ZhouA25/MakeCu2026/docs/design/pillbot-studio-gui.jpg

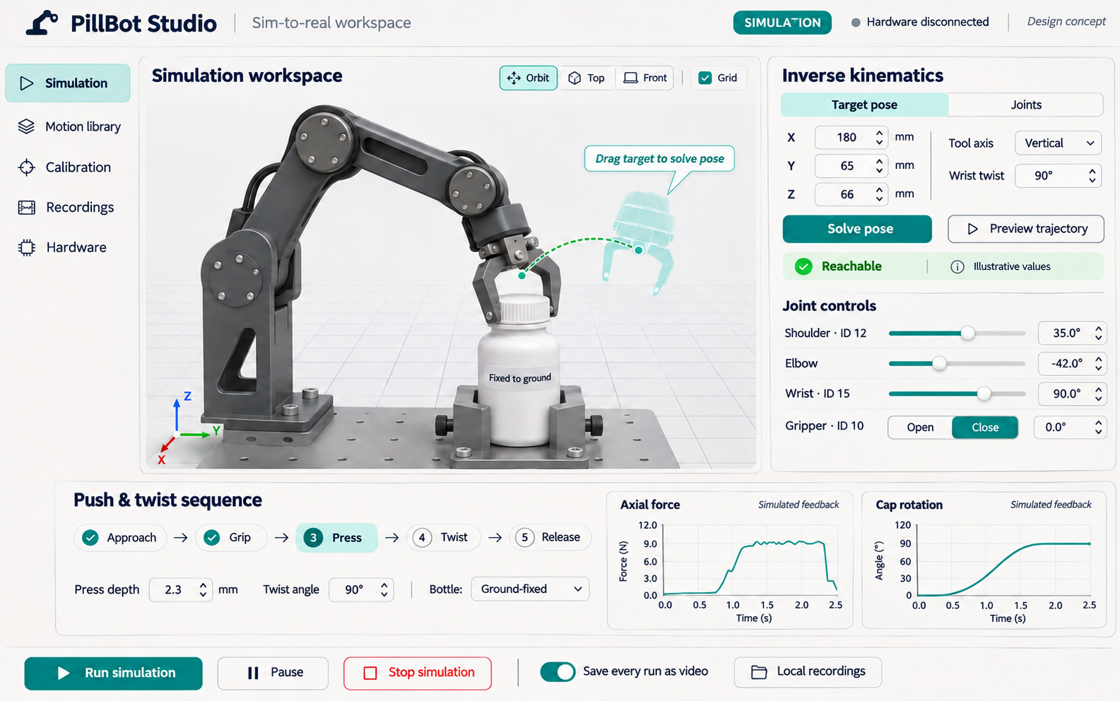
docs/design/pillbot-studio-gui.jpg
