ZhouA25/MakeCu2026/outputs/closed_loop/20261108T103255Z_grip_seed0_7902f1/00409_pass.png

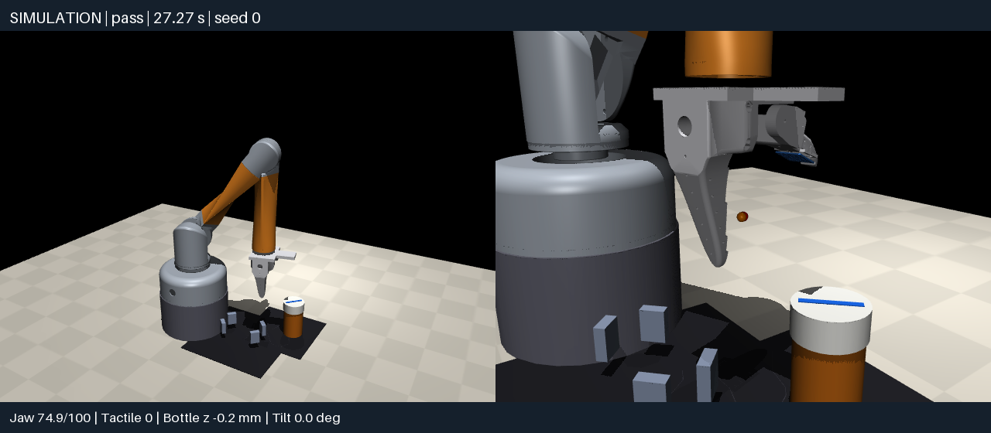
outputs/closed_loop/20261108T103255Z_grip_seed0_7902f1/00409_pass.png
