ZhouA25/MakeCu2026/docs/task-split.md

# Task split (fill in names)
| Area | Owner | Notes |
|---|---|---|
| Hardware: attachment CAD + printing | | hardware/cad, hardware/stl |
| Hardware: fixture + mounting | | |
| Robot setup: calibration, teleop, poses | | scripts/, control/teach.py |
| Control: open sequence tuning | | control/open_sequence.py |
| Perception | | perception/ |
| ML: record demos + train ACT | | scripts/record.sh, train.sh |
| Pitch + video | | docs/demo-plan.md |
