ZhouA25/MakeCu2026/outputs/closed_loop/20261108T103011Z_jaw_seed0_3709e4/00000_initial.png

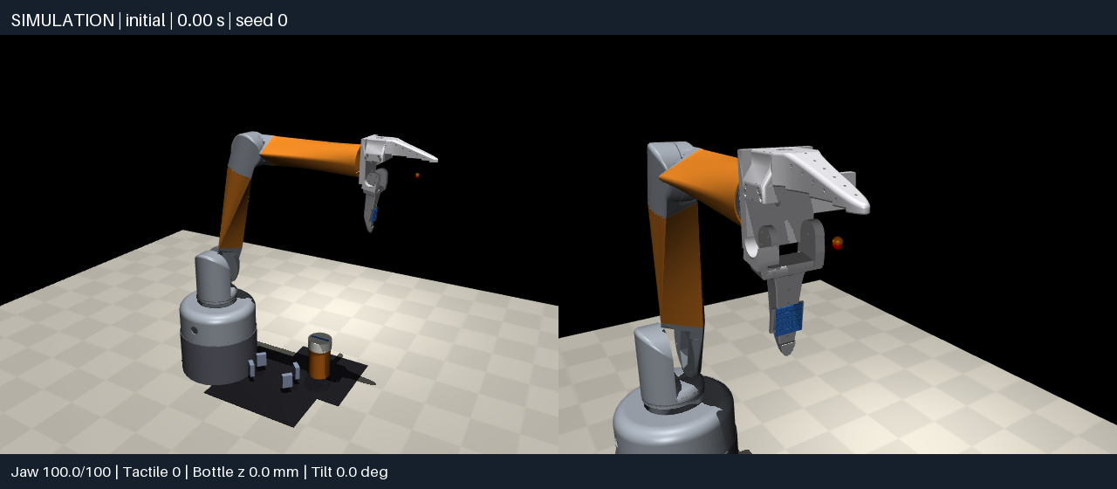
outputs/closed_loop/20261108T103011Z_jaw_seed0_3709e4/00000_initial.png
