ZhouA25/MakeCu2026/outputs/closed_loop/20261108T103031Z_grip_seed0_62903d/00387_fail.png

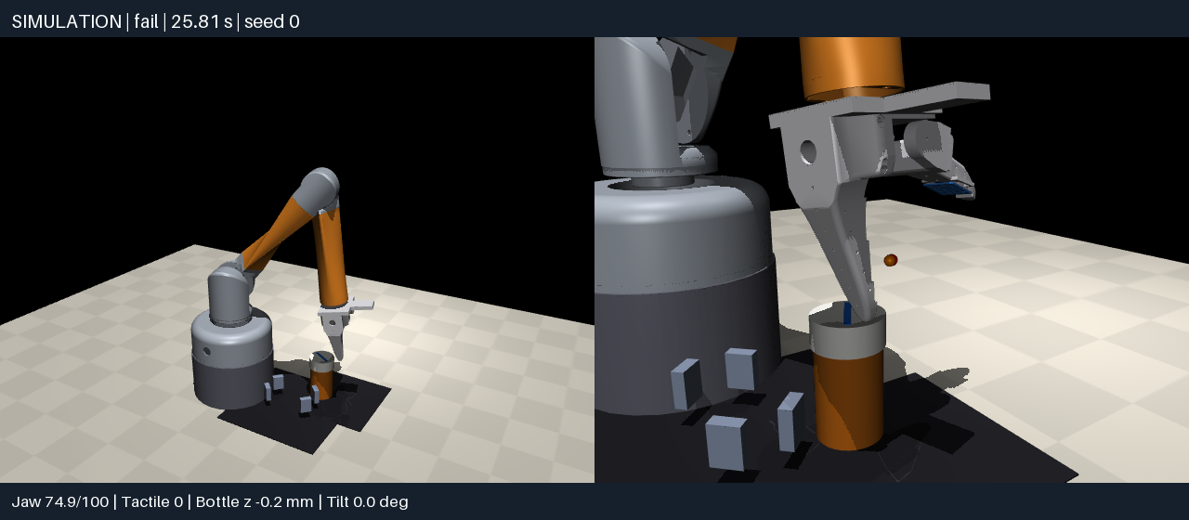
outputs/closed_loop/20261108T103031Z_grip_seed0_62903d/00387_fail.png
