ZhouA25/MakeCu2026/outputs/closed_loop/20261108T103538Z_grip_seed2_18e1b5/00332_lower.png

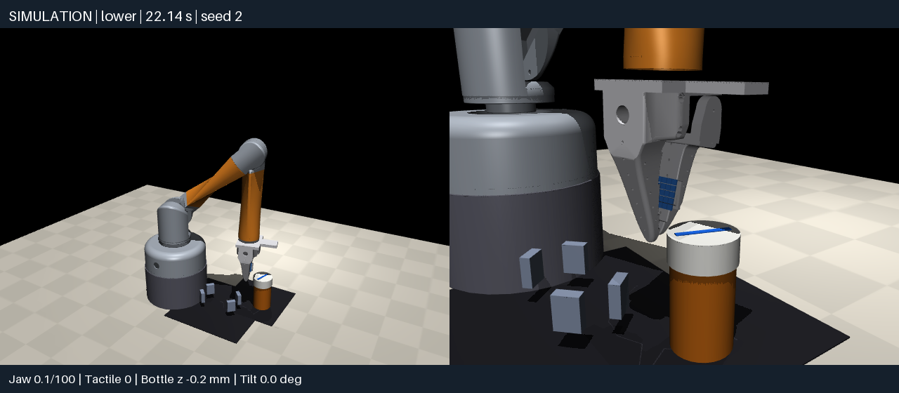
outputs/closed_loop/20261108T103538Z_grip_seed2_18e1b5/00332_lower.png
