ZhouA25/MakeCu2026/outputs/closed_loop/20261108T103726Z_grip_seed3_9e252f/00195_descend.png

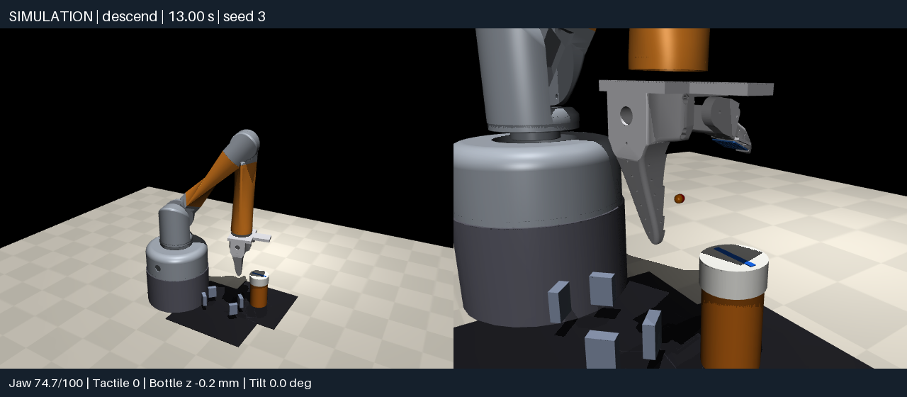
outputs/closed_loop/20261108T103726Z_grip_seed3_9e252f/00195_descend.png
