ZhouA25/MakeCu2026/outputs/closed_loop/20261108T120756Z_grip_seed3_d085e1/00521_failed.png

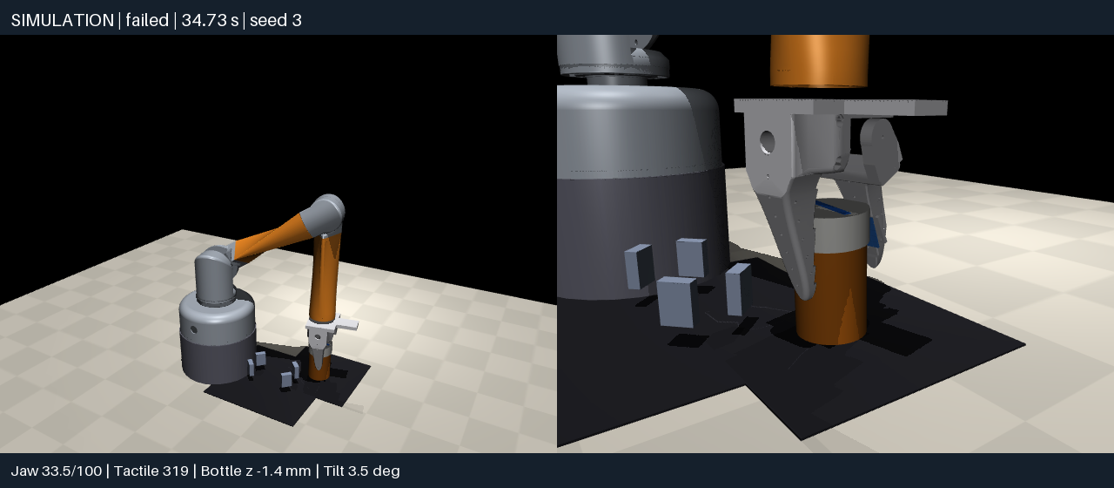
outputs/closed_loop/20261108T120756Z_grip_seed3_d085e1/00521_failed.png
