ZhouA25/MakeCu2026/outputs/closed_loop/20261108T121200Z_grip_seed1_65a573/00431_retreat.png

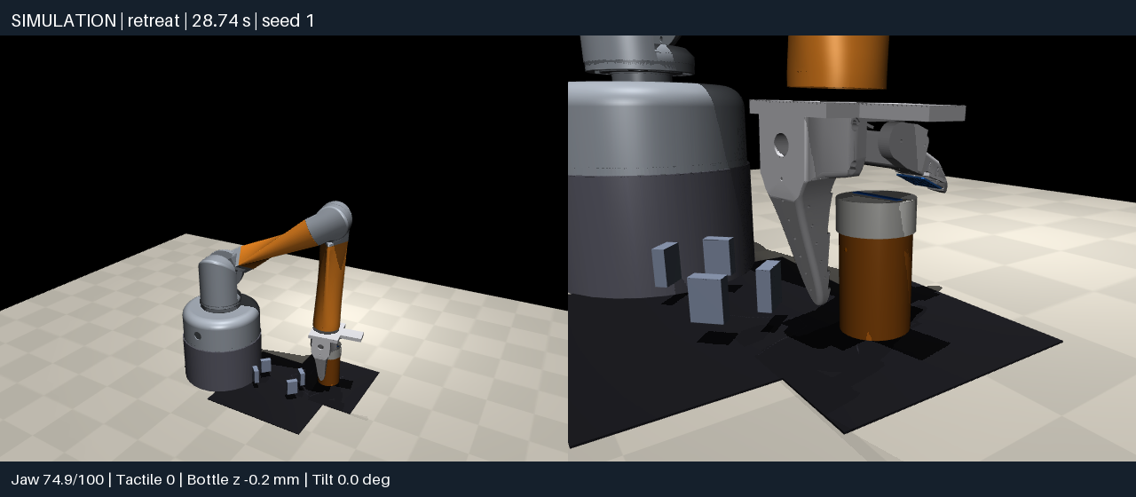
outputs/closed_loop/20261108T121200Z_grip_seed1_65a573/00431_retreat.png
