ZhouA25/MakeCu2026/outputs/closed_loop/20261108T121409Z_grip_seed1_edb14e/00362_retreat.png

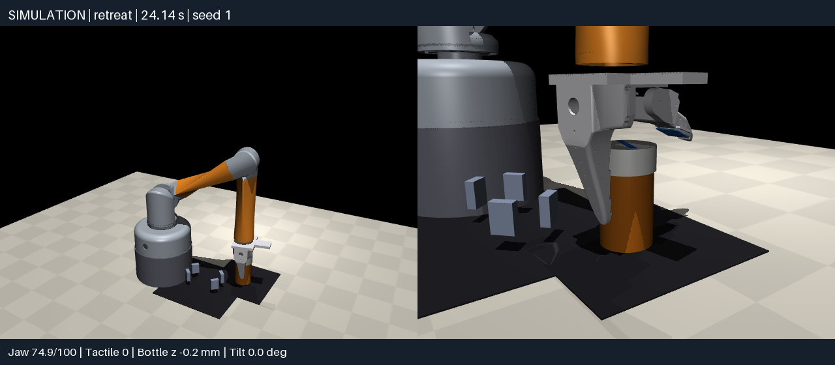
outputs/closed_loop/20261108T121409Z_grip_seed1_edb14e/00362_retreat.png
