ZhouA25/MakeCu2026/outputs/closed_loop/20261108T121611Z_grip_seed3_acc831/00269_hold_feedback.png

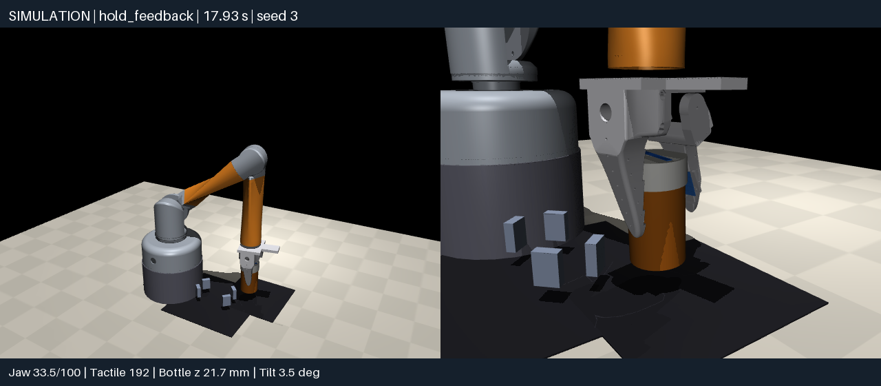
outputs/closed_loop/20261108T121611Z_grip_seed3_acc831/00269_hold_feedback.png
