ZhouA25/MakeCu2026/outputs/closed_loop/20261108T124435Z_fixed_push_twist_seed0_2ac45e/00317_release_cap.png

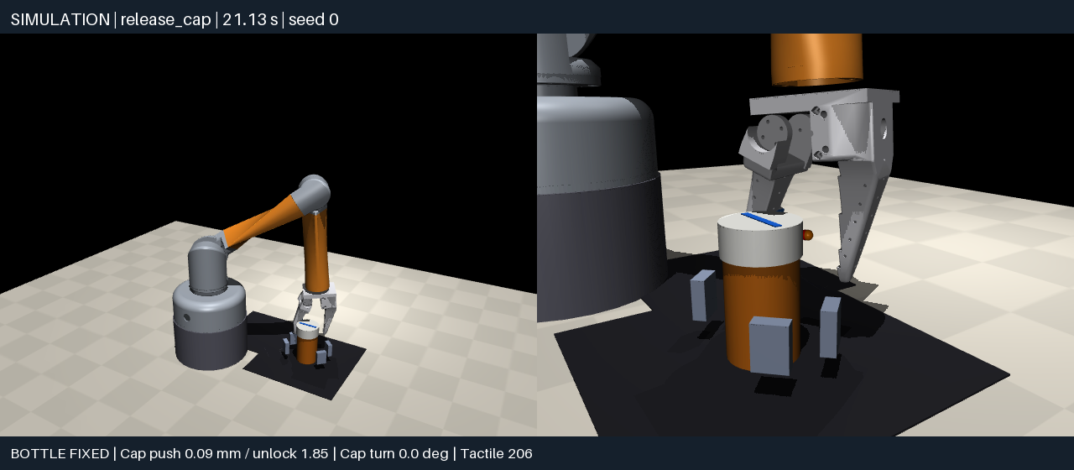
outputs/closed_loop/20261108T124435Z_fixed_push_twist_seed0_2ac45e/00317_release_cap.png
