ZhouA25/MakeCu2026/outputs/closed_loop/20261108T124616Z_fixed_push_twist_seed0_0a20aa/00421_release_cap.png

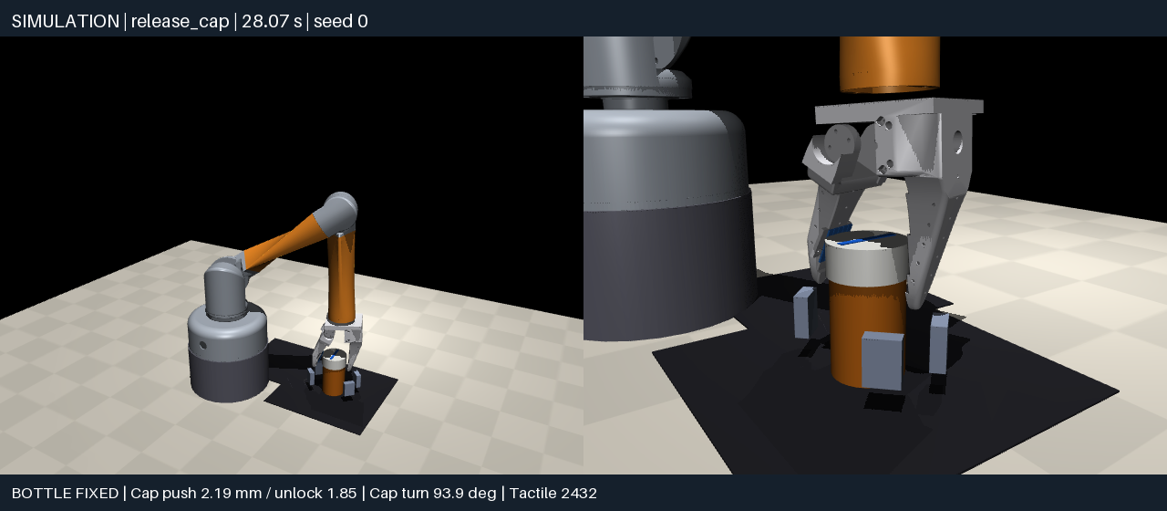
outputs/closed_loop/20261108T124616Z_fixed_push_twist_seed0_0a20aa/00421_release_cap.png
