ZhouA25/MakeCu2026/outputs/assembly_review/parts.png

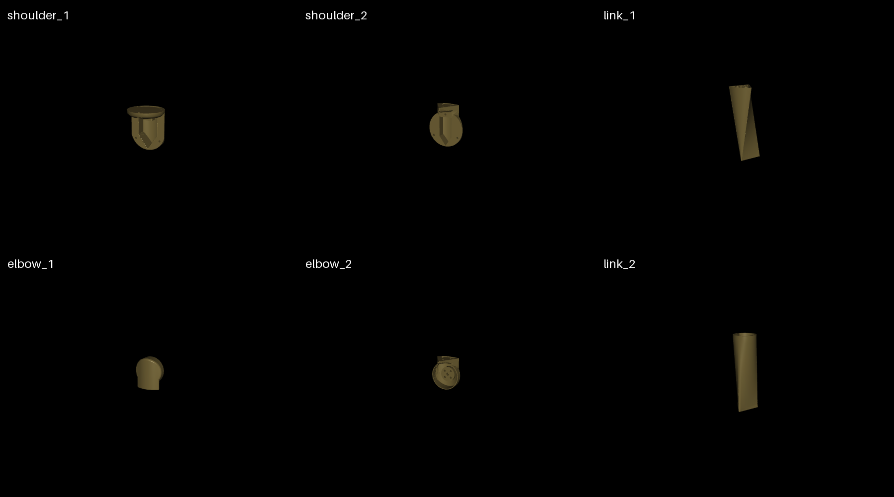
outputs/assembly_review/parts.png
