ZhouA25/MakeCu2026/hardware/stl/base/base_mainframe.stl

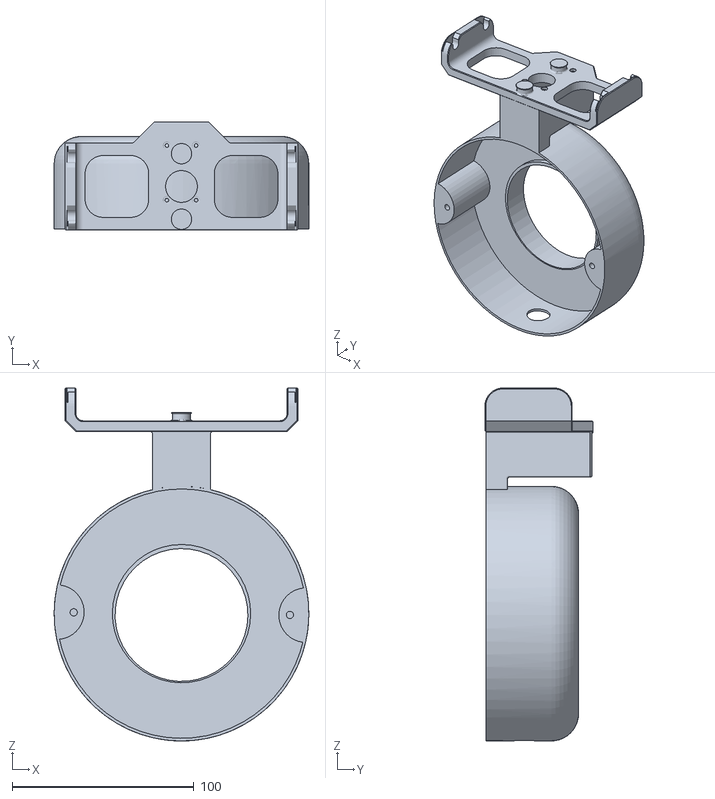
[picture p19: CAD file, 2026-11-08]
hardware/stl/base/base_mainframe.stl
140.0 x 59.5 x 194.0
