ZhouA25/MakeCu2026/hardware/stl/arm/link_1.stl

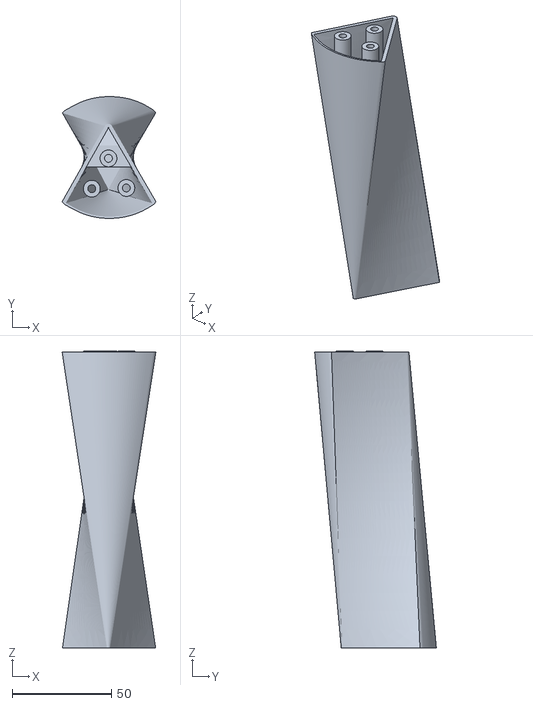
[picture p20: CAD file, 2026-11-08]
hardware/stl/arm/link_1.stl
47.4 x 61.5 x 150.0
