ZhouA25/MakeCu2026/hardware/stl/clamp/gear_rack_RB9.01.062.030.stl

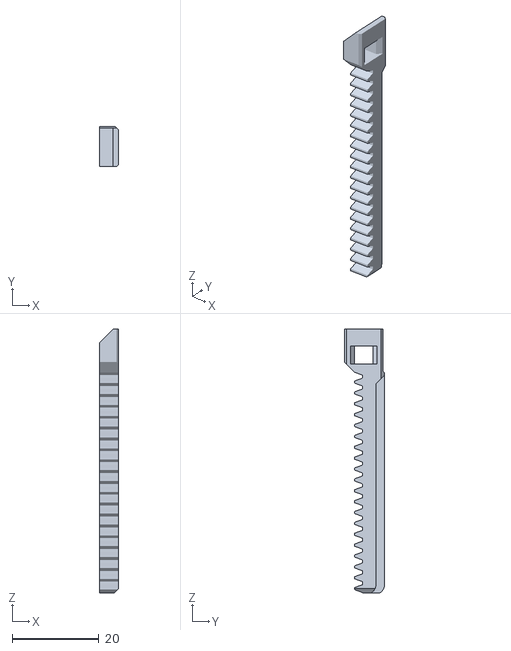
[picture p21: CAD file, 2026-11-08]
hardware/stl/clamp/gear_rack_RB9.01.062.030.stl
4.50 x 9.35 x 61.0
