ZhouA25/MakeCu2026/hardware/stl/gripper_so101/wrist_roll_follower_so101.stl

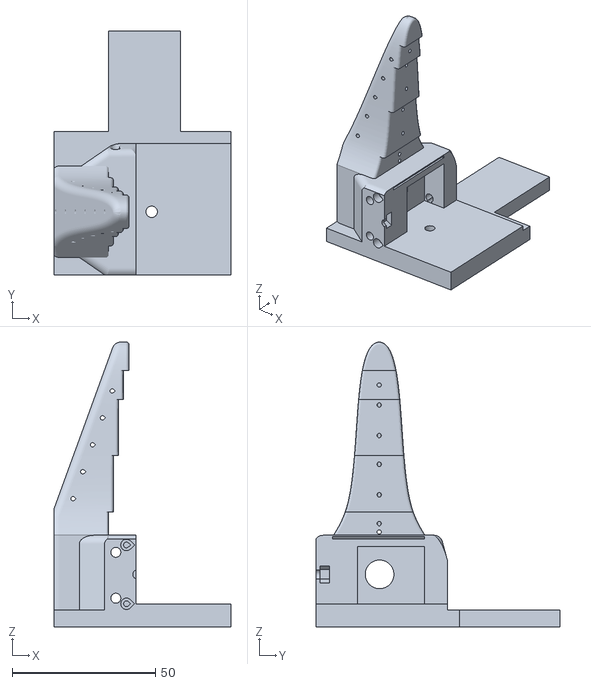
[picture p22: CAD file, 2026-11-08]
hardware/stl/gripper_so101/wrist_roll_follower_so101.stl
61.6 x 85.0 x 99.4
