ZhouA25/MakeCu2026/hardware/stl/clamp/clamp_jaw_RB9.01.062.021_x2.stl

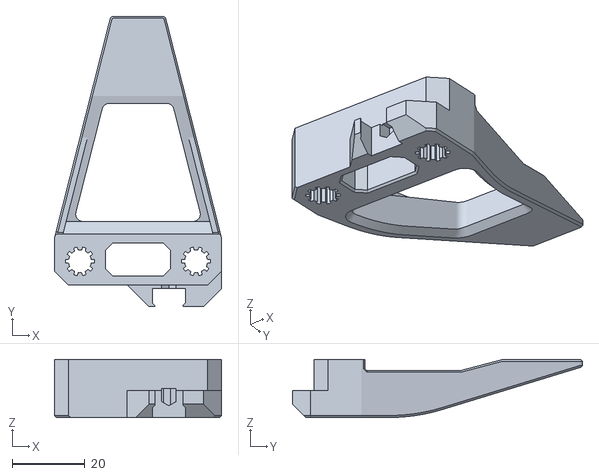
[picture p24: CAD file, 2026-11-08]
hardware/stl/clamp/clamp_jaw_RB9.01.062.021_x2.stl
46.0 x 80.0 x 16.0
