ZhouA25/MakeCu2026/hardware/stl/gripper_so101/moving_jaw_so101.stl

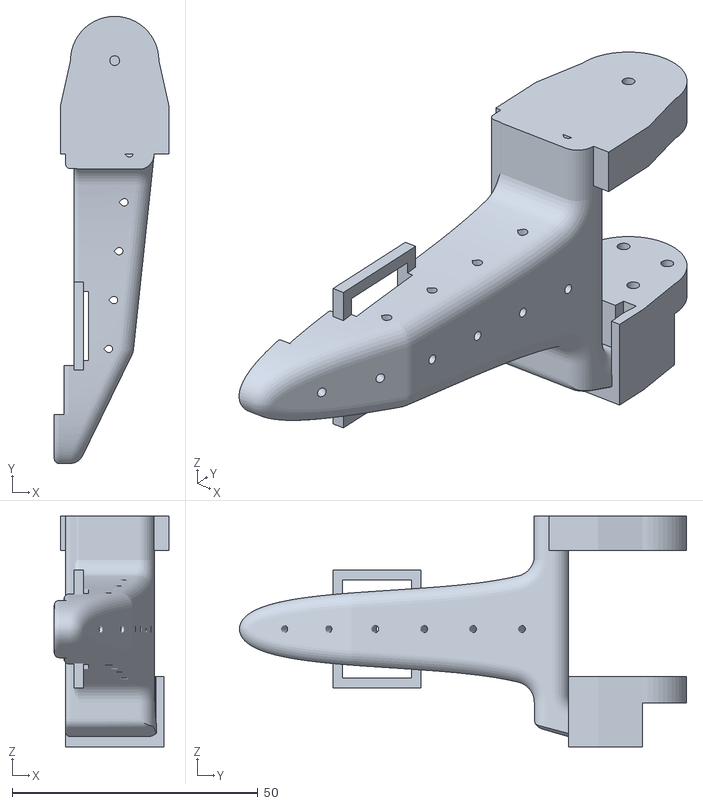
[picture p25: CAD file, 2026-11-08]
hardware/stl/gripper_so101/moving_jaw_so101.stl
23.3 x 91.0 x 47.0
