ZhouA25/MakeCu2026/hardware/stl/arm/elbow_coupler.stl

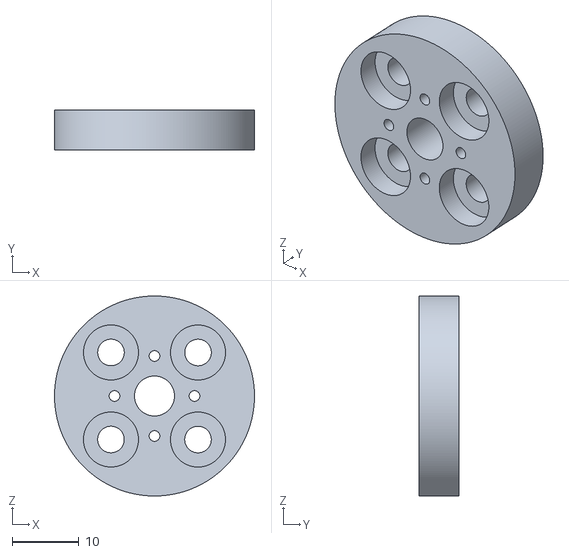
[picture p26: CAD file, 2026-11-08]
hardware/stl/arm/elbow_coupler.stl
30.0 x 6.00 x 30.0
