ZhouA25/MakeCu2026/hardware/stl/clamp/nail_RB9.01.062.100_x2.stl

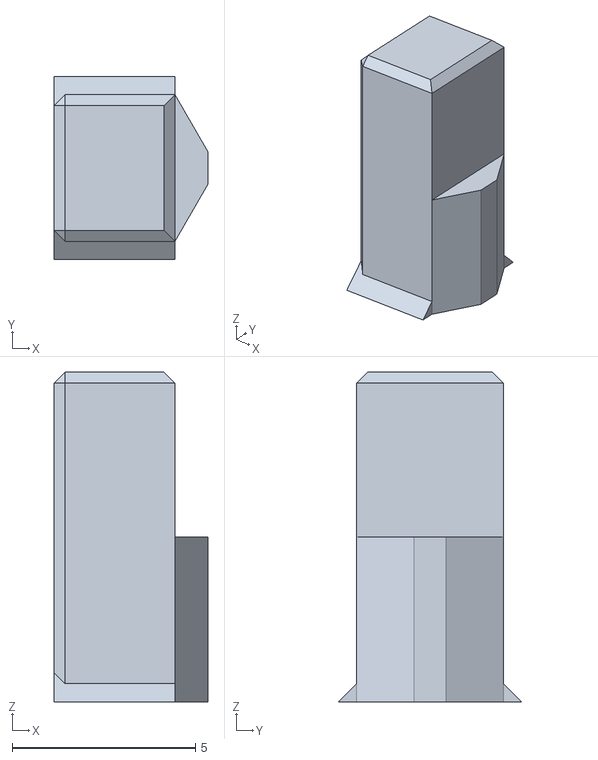
[picture p27: CAD file, 2026-11-08]
hardware/stl/clamp/nail_RB9.01.062.100_x2.stl
4.20 x 5.00 x 9.00
