ZhouA25/MakeCu2026/hardware/stl/arm/base_plate.stl

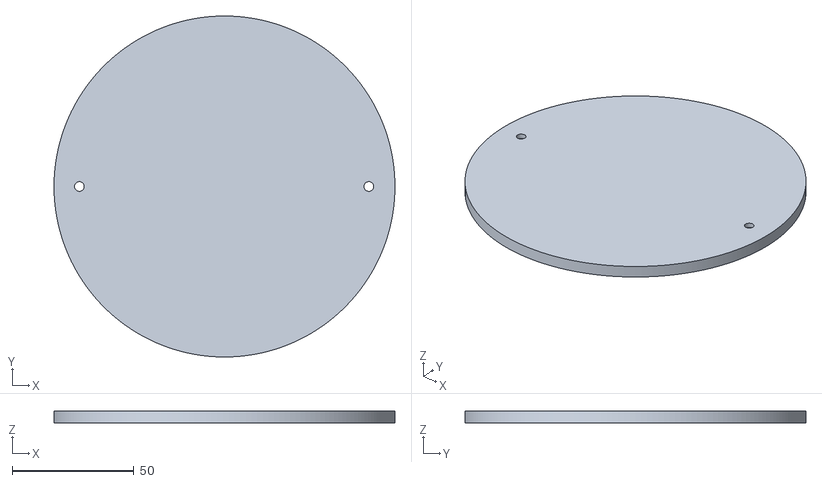
[picture p28: CAD file, 2026-11-08]
hardware/stl/arm/base_plate.stl
140.0 x 140.0 x 5.00
