ZhouA25/MakeCu2026/hardware/stl/arm/hand_plate.stl

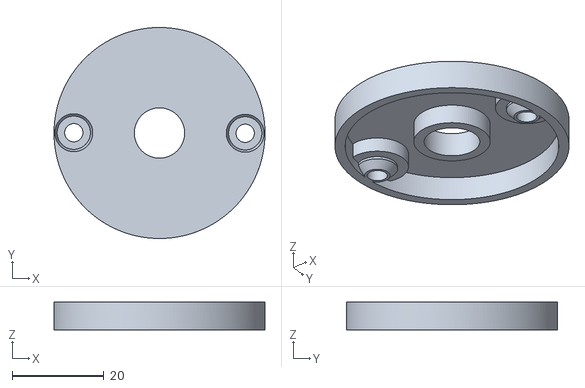
[picture p29: CAD file, 2026-11-08]
hardware/stl/arm/hand_plate.stl
46.0 x 46.0 x 6.00
