ZhouA25/MakeCu2026/hardware/stl/arm/shoulder_1.stl

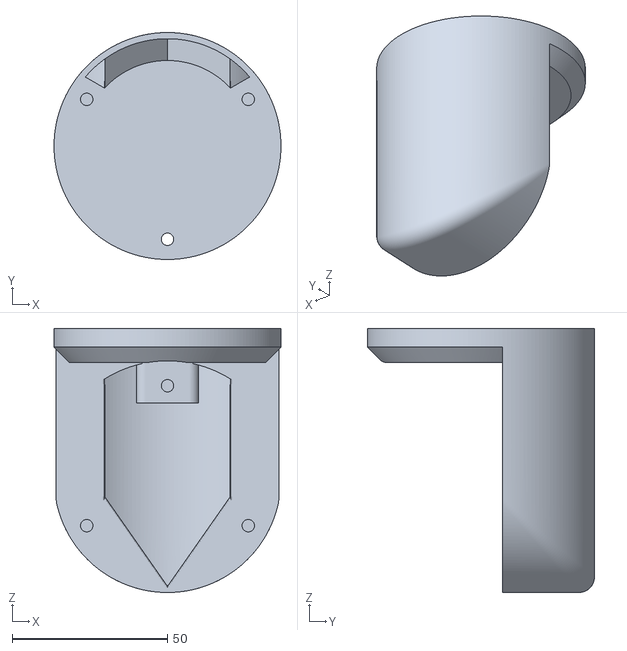
[picture p30: CAD file, 2026-11-08]
hardware/stl/arm/shoulder_1.stl
73.0 x 73.0 x 84.9
