ZhouA25/MakeCu2026/hardware/stl/arm/base.stl

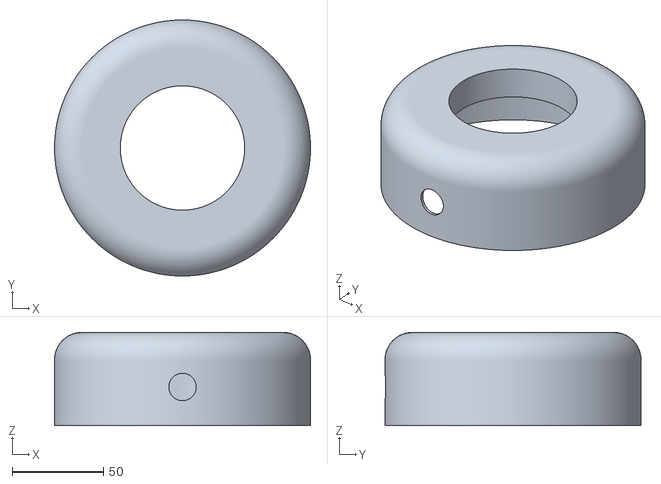
[picture p31: CAD file, 2026-11-08]
hardware/stl/arm/base.stl
140.0 x 140.0 x 51.0
