ZhouA25/MakeCu2026/hardware/stl/arm/sun_gear.stl

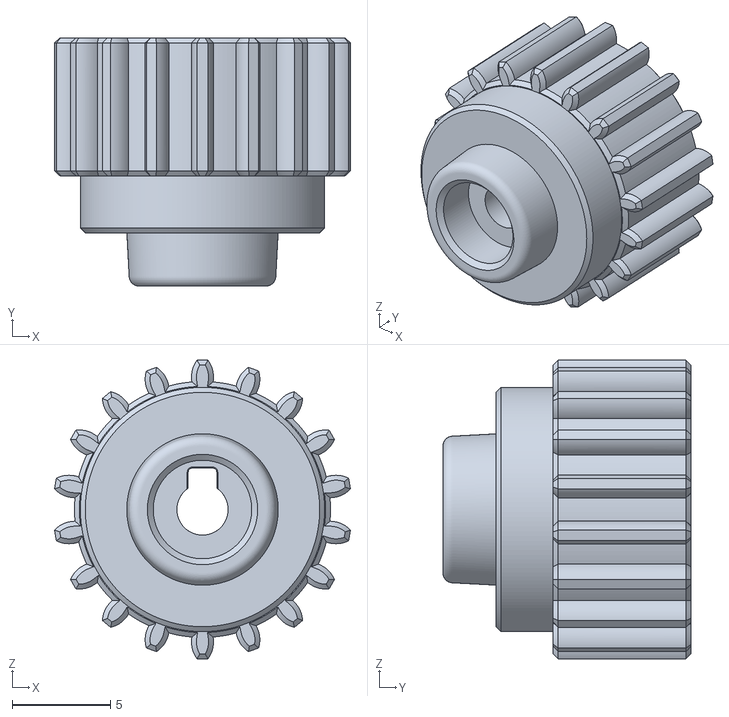
[picture p32: CAD file, 2026-11-08]
hardware/stl/arm/sun_gear.stl
15.0 x 12.6 x 15.2
