ZhouA25/MakeCu2026/hardware/stl/arm/wrist_gear_1.stl

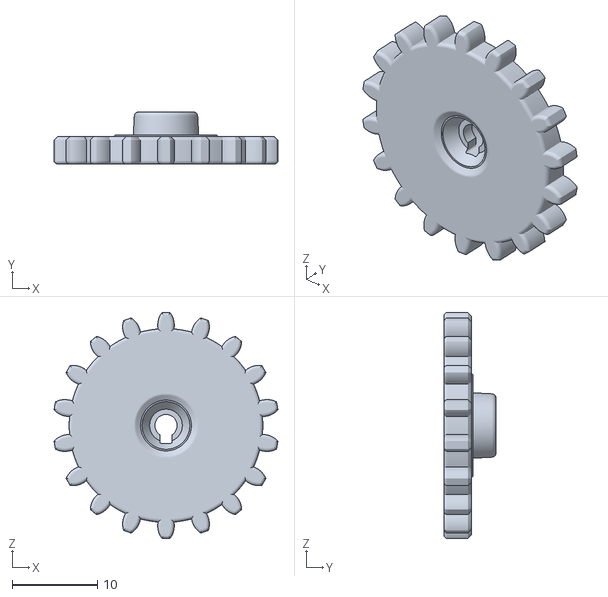
[picture p33: CAD file, 2026-11-08]
hardware/stl/arm/wrist_gear_1.stl
26.3 x 6.10 x 26.5
