ZhouA25/MakeCu2026/hardware/stl/arm/link_2.stl

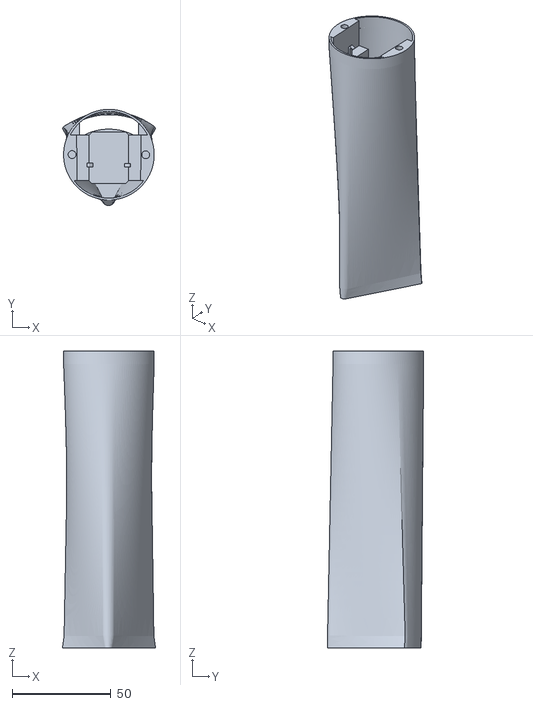
[picture p34: CAD file, 2026-11-08]
hardware/stl/arm/link_2.stl
47.3 x 48.8 x 150.7
