ZhouA25/MakeCu2026/hardware/stl/arm/shoulder_2.stl

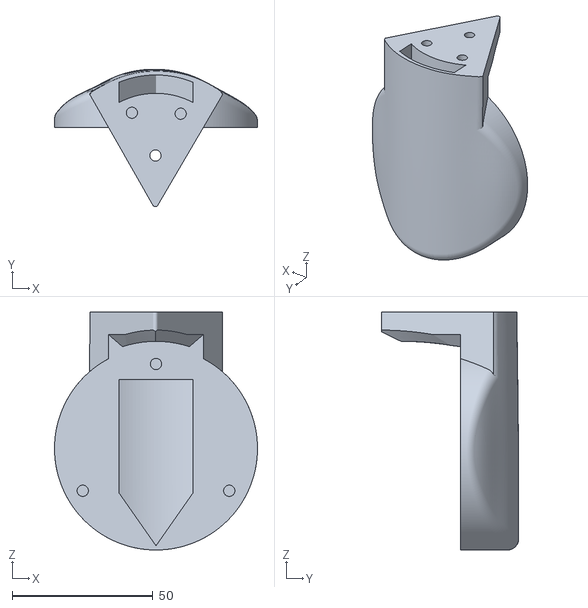
[picture p35: CAD file, 2026-11-08]
hardware/stl/arm/shoulder_2.stl
72.0 x 48.7 x 84.4
