ZhouA25/MakeCu2026/hardware/stl/arm/elbow_2.stl

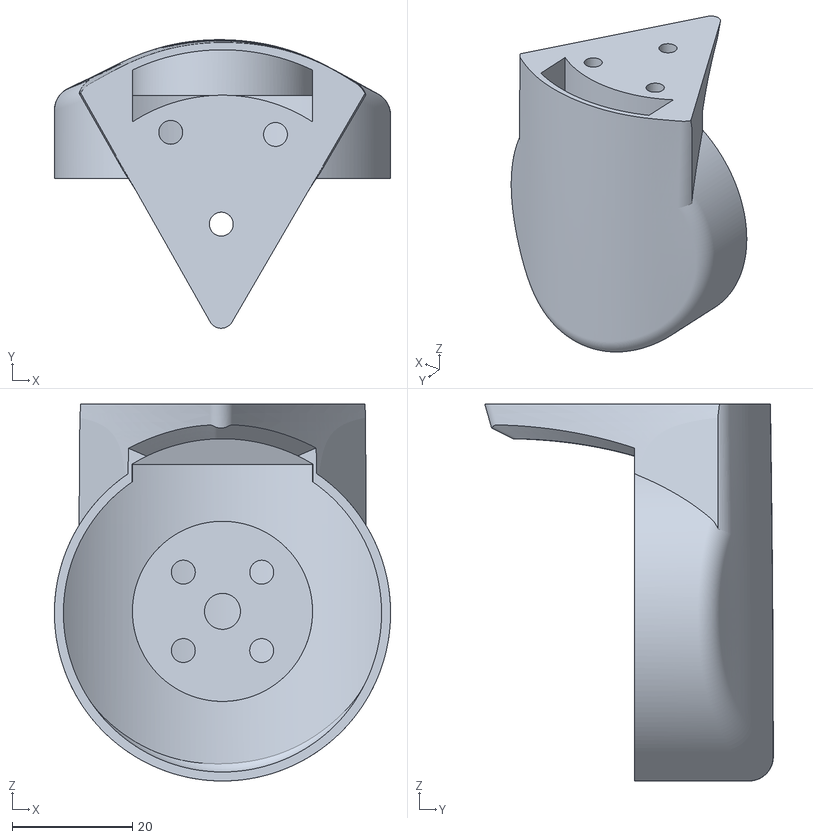
[picture p36: CAD file, 2026-11-08]
hardware/stl/arm/elbow_2.stl
56.0 x 48.1 x 62.8
