ZhouA25/MakeCu2026/hardware/stl/arm/drive_plate.stl

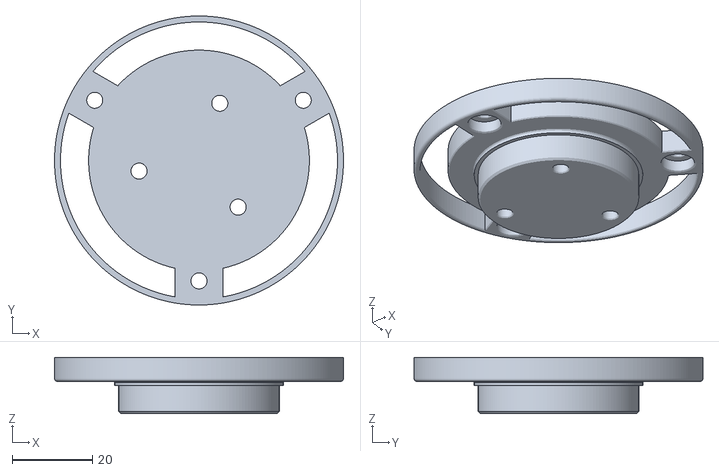
[picture p37: CAD file, 2026-11-08]
hardware/stl/arm/drive_plate.stl
72.0 x 72.0 x 14.0
