ZhouA25/MakeCu2026/hardware/stl/arm/planet_gear_5mm_hole.stl

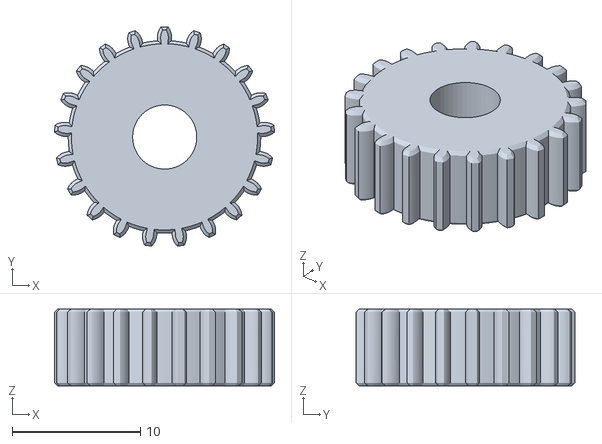
[picture p38: CAD file, 2026-11-08]
hardware/stl/arm/planet_gear_5mm_hole.stl
17.2 x 17.1 x 6.00
