ZhouA25/MakeCu2026/hardware/stl/arm/wrist_gear_2.stl

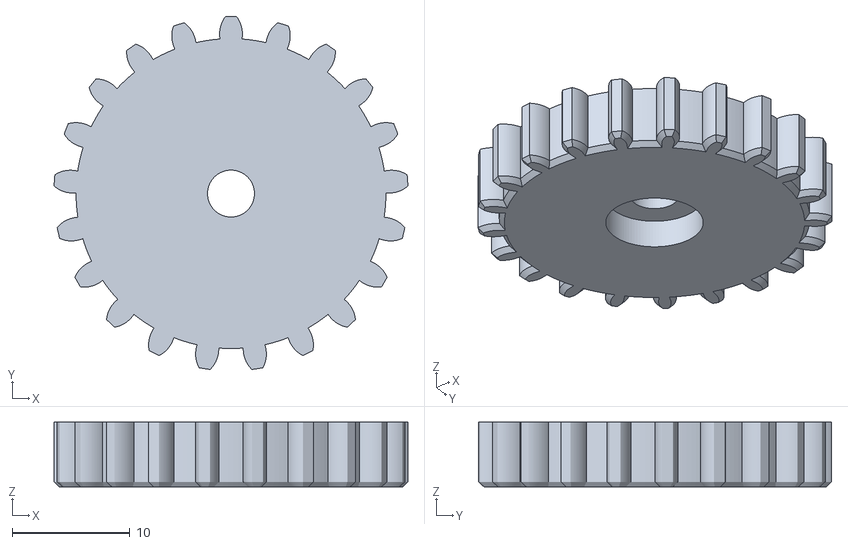
[picture p39: CAD file, 2026-11-08]
hardware/stl/arm/wrist_gear_2.stl
30.0 x 29.9 x 5.50
