ZhouA25/MakeCu2026/hardware/stl/arm/planetary_gear_box.stl

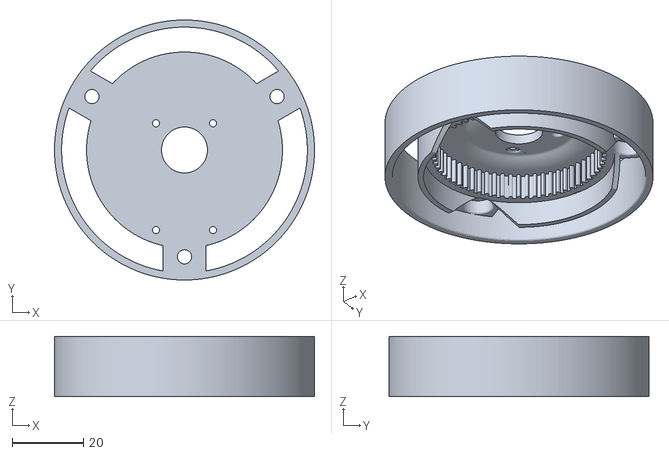
[picture p40: CAD file, 2026-11-08]
hardware/stl/arm/planetary_gear_box.stl
73.0 x 73.0 x 16.9
