ZhouA25/MakeCu2026/hardware/stl/arm/hand.stl

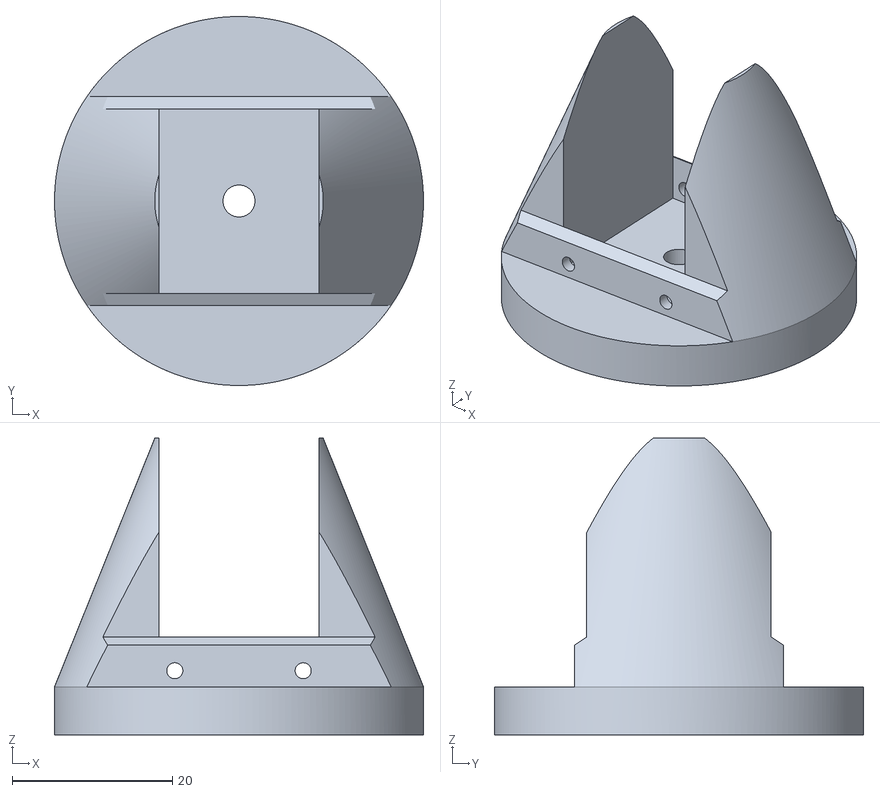
[picture p41: CAD file, 2026-11-08]
hardware/stl/arm/hand.stl
46.0 x 46.0 x 37.0
