ZhouA25/MakeCu2026/hardware/stl/arm/eef.stl

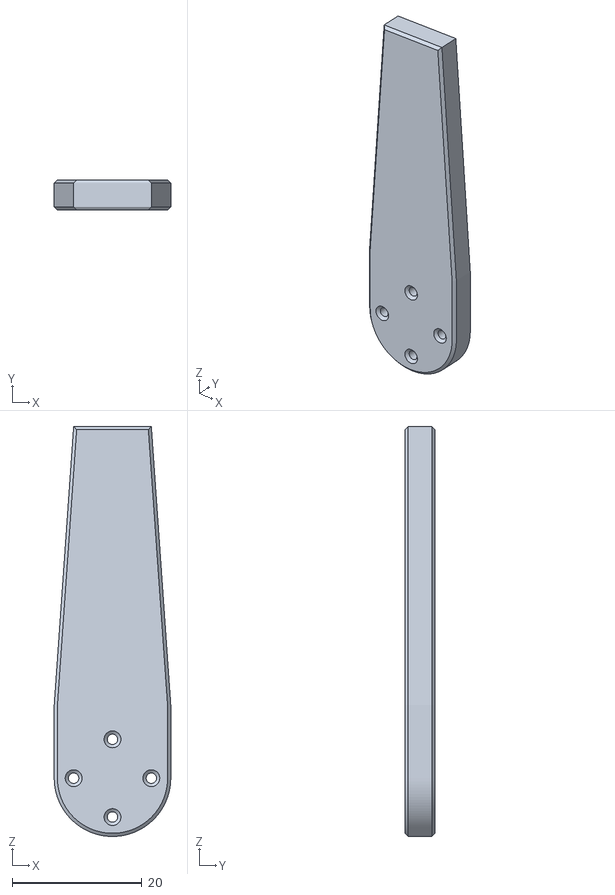
[picture p42: CAD file, 2026-11-08]
hardware/stl/arm/eef.stl
18.0 x 4.70 x 63.3
