ZhouA25/MakeCu2026/(list of files, cad)

Other CAD files:
hardware/stl/clamp/gear_rack_RB9.01.062.031.stl
hardware/stl/arm/planet_gears.stl
