ZhouA25/MakeCu2026/outputs/assembly_review/assembly.png

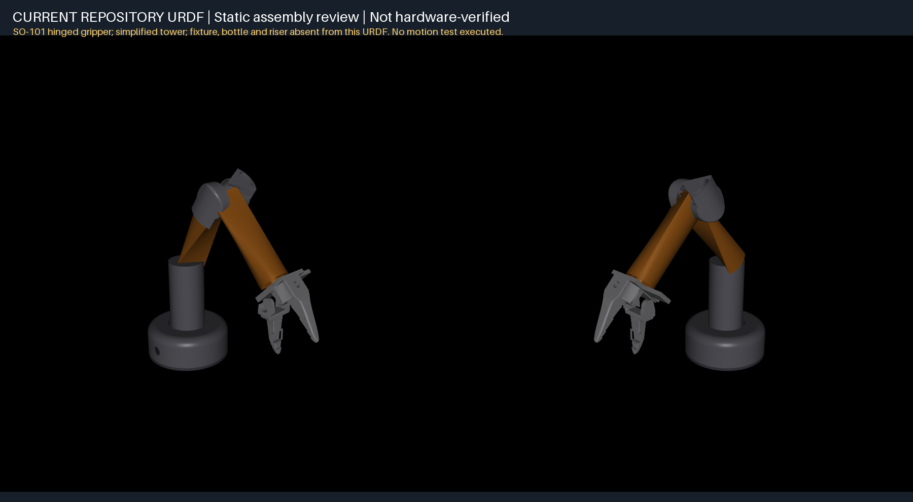
outputs/assembly_review/assembly.png
