ZhouA25/MakeCu2026/outputs/assembly_review_v2/assembly.png

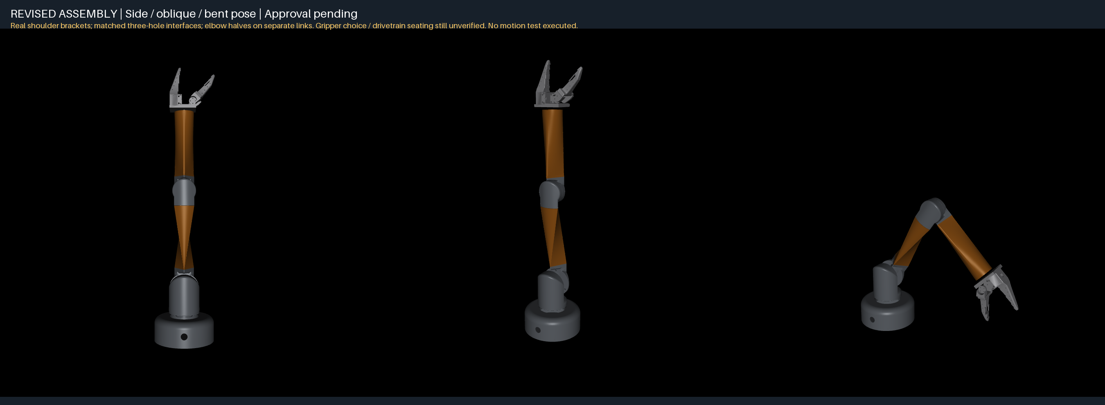
outputs/assembly_review_v2/assembly.png
