ZhouA25/MakeCu2026/outputs/assembly_review_v2/hole_alignment.png

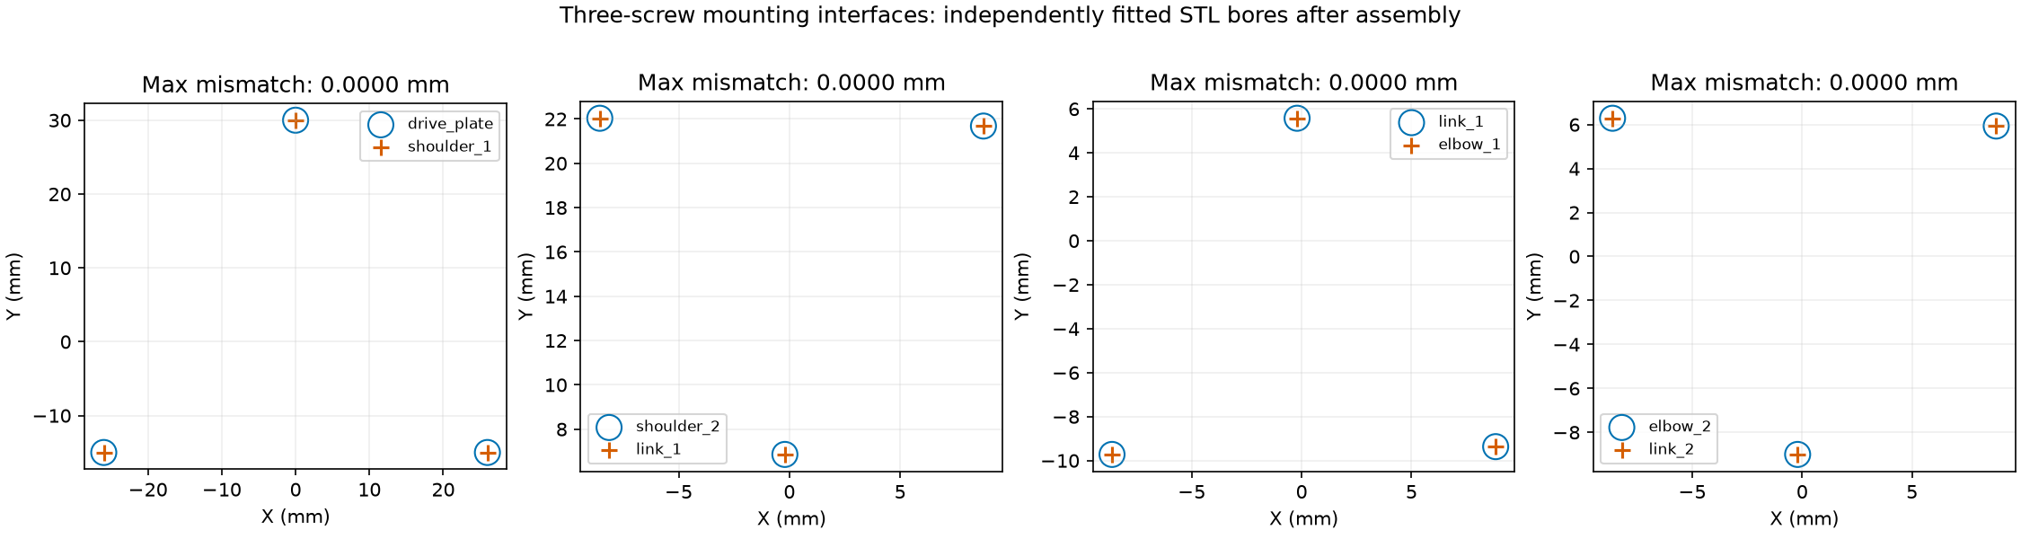
outputs/assembly_review_v2/hole_alignment.png
