ZhouA25/MakeCu2026/outputs/closed_loop/validation-summary.md

# Local closed-loop validation videos

Simulation only. Every executed trial, including failures, is retained below.

Latest bottle-grip controller cohort: **5/5 passed**; seeds [1, 0, 2, 3, 4].
All 25 completed videos passed first/last-frame and frame-count checks.

## Latest controller cohort

| Seed | Pass | Minimum hold height (mm) | Contact fraction | Maximum drift (mm) | Video |
|---|---|---|---|---|---|
| 1 | True | 19.97 | 1.00 | 0.181 | [MP4](20261108T121409Z_grip_seed1_edb14e/demo.mp4) |
| 0 | True | 22.30 | 1.00 | 0.140 | [MP4](20261108T121528Z_grip_seed0_0c8cb4/demo.mp4) |
| 2 | True | 22.25 | 1.00 | 0.138 | [MP4](20261108T121528Z_grip_seed2_85d43b/demo.mp4) |
| 3 | True | 21.51 | 1.00 | 0.136 | [MP4](20261108T121611Z_grip_seed3_acc831/demo.mp4) |
| 4 | True | 21.76 | 1.00 | 0.220 | [MP4](20261108T121649Z_grip_seed4_03598a/demo.mp4) |

## Bottle fixed to ground: push and twist

| Run | Pass | Cap rotation (deg) | Bottle displacement (mm) | Video |
|---|---|---|---|---|
| 20261108T124435Z_fixed_push_twist_seed0_2ac45e | False | 0.01 | 0.000000 | [MP4](20261108T124435Z_fixed_push_twist_seed0_2ac45e/demo.mp4) |
| 20261108T124616Z_fixed_push_twist_seed0_0a20aa | True | 93.92 | 0.000000 | [MP4](20261108T124616Z_fixed_push_twist_seed0_0a20aa/demo.mp4) |

## Complete trial history

| Run | Result | Duration (s) | Video |
|---|---|---|---|
| 20261108T103011Z_jaw_seed0_3709e4 | PASS | 8.1 | [MP4](20261108T103011Z_jaw_seed0_3709e4/demo.mp4) |
| 20261108T103031Z_grip_seed0_62903d | FAIL | 26.2 | [MP4](20261108T103031Z_grip_seed0_62903d/demo.mp4) |
| 20261108T103255Z_grip_seed0_7902f1 | PASS | 27.7 | [MP4](20261108T103255Z_grip_seed0_7902f1/demo.mp4) |
| 20261108T103424Z_grip_seed1_3de6ac | FAIL | 34.7 | [MP4](20261108T103424Z_grip_seed1_3de6ac/demo.mp4) |
| 20261108T103424Z_grip_seed3_d7511e | FAIL | 19.2 | [MP4](20261108T103424Z_grip_seed3_d7511e/demo.mp4) |
| 20261108T103504Z_grip_seed4_2e3649 | FAIL | 17.9 | [MP4](20261108T103504Z_grip_seed4_2e3649/demo.mp4) |
| 20261108T103538Z_grip_seed2_18e1b5 | FAIL | 30.2 | [MP4](20261108T103538Z_grip_seed2_18e1b5/demo.mp4) |
| 20261108T103726Z_grip_seed3_9e252f | FAIL | 34.7 | [MP4](20261108T103726Z_grip_seed3_9e252f/demo.mp4) |
| 20261108T120756Z_grip_seed3_d085e1 | FAIL | 34.8 | [MP4](20261108T120756Z_grip_seed3_d085e1/demo.mp4) |
| 20261108T120929Z_grip_seed1_b7ccbf | FAIL | 16.4 | [MP4](20261108T120929Z_grip_seed1_b7ccbf/demo.mp4) |
| 20261108T120929Z_grip_seed3_8b5354 | PASS | 25.9 | [MP4](20261108T120929Z_grip_seed3_8b5354/demo.mp4) |
| 20261108T120956Z_grip_seed2_20b837 | PASS | 26.0 | [MP4](20261108T120956Z_grip_seed2_20b837/demo.mp4) |
| 20261108T121011Z_grip_seed4_994cd3 | PASS | 25.9 | [MP4](20261108T121011Z_grip_seed4_994cd3/demo.mp4) |
| 20261108T121118Z_grip_seed0_08f080 | PASS | 25.9 | [MP4](20261108T121118Z_grip_seed0_08f080/demo.mp4) |
| 20261108T121118Z_grip_seed3_dd5979 | PASS | 25.9 | [MP4](20261108T121118Z_grip_seed3_dd5979/demo.mp4) |
| 20261108T121200Z_grip_seed1_65a573 | FAIL | 31.8 | [MP4](20261108T121200Z_grip_seed1_65a573/demo.mp4) |
| 20261108T121200Z_grip_seed4_ffd8fc | PASS | 25.9 | [MP4](20261108T121200Z_grip_seed4_ffd8fc/demo.mp4) |
| 20261108T121249Z_grip_seed2_09fc4a | PASS | 26.0 | [MP4](20261108T121249Z_grip_seed2_09fc4a/demo.mp4) |
| 20261108T121409Z_grip_seed1_edb14e | PASS | 27.1 | [MP4](20261108T121409Z_grip_seed1_edb14e/demo.mp4) |
| 20261108T121528Z_grip_seed0_0c8cb4 | PASS | 25.9 | [MP4](20261108T121528Z_grip_seed0_0c8cb4/demo.mp4) |
| 20261108T121528Z_grip_seed2_85d43b | PASS | 26.2 | [MP4](20261108T121528Z_grip_seed2_85d43b/demo.mp4) |
| 20261108T121611Z_grip_seed3_acc831 | PASS | 25.9 | [MP4](20261108T121611Z_grip_seed3_acc831/demo.mp4) |
| 20261108T121649Z_grip_seed4_03598a | PASS | 25.9 | [MP4](20261108T121649Z_grip_seed4_03598a/demo.mp4) |
| 20261108T124435Z_fixed_push_twist_seed0_2ac45e | FAIL | 26.3 | [MP4](20261108T124435Z_fixed_push_twist_seed0_2ac45e/demo.mp4) |
| 20261108T124616Z_fixed_push_twist_seed0_0a20aa | PASS | 33.5 | [MP4](20261108T124616Z_fixed_push_twist_seed0_0a20aa/demo.mp4) |

Scope: one bottle profile, known bench target, limited randomized placement/mass/friction. Fixed-body twist is an instrumented simulation stroke; full cap removal is not demonstrated. No real hardware, vision validation or new policy training is claimed.
