ZhouA25/MakeCu2026/firmware/esp32_cam/secrets.example.h

// Copy this file to secrets.h (same folder) and fill in your 2.4 GHz Wi-Fi.
// secrets.h is git-ignored so your password never lands on GitHub.
#define WIFI_SSID_VALUE "YOUR_WIFI"
#define WIFI_PASS_VALUE ""   // "" for an open network
