ZhouA25/MakeCu2026/(commit log)

2026-11-07 setup of arm and such, as well as proptype
    [robot.yaml]
2026-11-07 PillBot scaffold: control, perception, sensors, ESP32 hub, LeRobot XL330 plugin; add sensx_python submodule
2026-11-07 changing to suit hardware we have available, and setting up simulkations tests
    [robot.yaml]
2026-11-07 added camera hardware code
    [robot.yaml]
2026-11-07 Clamp + push-and-twist, fixture bench, ESP32-CAM
    [robot.yaml]
2026-11-07 cleaning things up
    [robot.yaml]
2026-11-07 Integrate SensX25 tactile sensor: fixes, tools, sharing, docs
    - SensXTactile: detect "no frames" correctly (the driver's frame starts as
    zeros, never None), and treat frames older than max_age_s as no data, so an
    unplugged sensor no longer reads as a frozen "still gripping"
    - TactileSnapshot / snapshot(): pressure, contact, centroid from one frame
    - open_tactile(): config + connect + tare in one line for standalone scripts
    - tactile_server + NetTactile ("net" backend): share one sensor with several
    programs, other machines or other languages (JSON lines over TCP)
    - sensx_probe: port discovery and single/hub protocol detection
    - tools/tactile_live: doctor, live view for tuning contact_t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
    [robot.yaml]
2026-11-07 Wrist-camera detection working
    [robot.yaml]
2026-11-08 Add MuJoCo simulation: trained reach policy, cap finding, real opener in physics
    - src/pillbot/sim: physics model of the arm, clamped bottle and child-proof
    cap (thread torque, push-to-unlock, release), 5x5 SensX-like touch pad,
    ESP32-CAM-like wrist camera; SimRobotIO / SimTactile run the real
    grasp.py and open_sequence.py unchanged
    - Reach-to-any-point policy (PPO) trained in sim: median 3.4 mm, 94% within
    10 mm over 100 random goals (models/sim/reach_ppo.zip)
    - Wrist-camera cap finding (background diff + geometry): ~1.5 mm median error
    - demo / workspace / train CLIs; 6 sim tests
    - open_sequence: verify the cap really came off (arm reached the lift pose and
    the pad still feels it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
    [robot.yaml]
2026-11-08 fixing bottle detection and making a dashboard
    [robot.yaml]
2026-11-08 Stable hub port: auto + ports tool
    [robot.yaml]
2026-11-08 Add team STLs; simulate the real arm with the SO-101 gripper; URDF for ROS
    - hardware/stl: all 26 team STLs, renamed and sorted (arm/, gripper_so101/,
    base/, clamp/) with a README of what each part is
    - Sim uses the STLs as visuals; gripper is now the SO-101 (fixed jaw + hinged
    moving jaw, hinge from the SO-101 URDF) with the SensX pad on the moving jaw;
    collisions are boxes fitted to the real jaw faces
    - sim/kinematics.py orbit_twist: the SO-101 holds the cap ~12 mm off the wrist
    axis, so twist with wrist + arm together; open_cap takes an optional twist=
    - Wrist camera aimed by IK on look-at points, mounted over the grip line; dark
    mat under the clip (cap finding 1.9 mm median)
    -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
    [base.stl, base_mainframe.stl, base_plate.stl, clamp_jaw_RB9.01.062.021_x2.stl, drive_plate.stl, eef.stl, elbow_1.stl, elbow_2.stl]
2026-11-08 fixing things
    [robot.yaml]
2026-11-08 sim: pick the bottle from a fixed spot, place and clamp it, then unscrew
    - The whole task now runs in the sim: pick from fixture.pick_xy, place in the clip, clamp, find the cap, open
    - It runs the team's real pick_bottle / place_in_clip / Fixture.clamp; a SimHub stands in for the ESP32 hub
    - The bottle is a free body; the clip has rack-coupled, self-centring clamp jaws kept below the SO-101 fingertips
    - The arm gets a round base riser and a 90° tool roll; placement aims the held bottle's base
    - Optional funnel pocket (fixture.pocket_slope_deg, off by default: 45° hurt)
    - Tests: child-proof test uses the recommended hardware and the coordinated twist
    - Docs: pipeline, findings, honest resul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
    [sim.yaml]
2026-11-08 fixed some issues with sim
    [robot.yaml]
2026-11-08 tweaked sim
    [pillbot.urdf]
2026-11-08 hopefully sim is better now
    [robot.yaml]
2026-11-08 Correct arm assembly and add recorded grip and fixed-bottle twist validation
    [pillbot.urdf, robot.yaml]
2026-11-08 adding info for arm setup and teaching
    [robot.yaml]
2026-11-08 final setup for testing
    [robot.yaml]
2026-11-08 Motor IDs, Windows venv setup, no-hub option, LF shell scripts
    [robot.yaml]
2026-11-09 commit for all tuning during expo
    [robot.yaml]
